octopus287/-STM32H7-/images/car_photos/car5.jpg

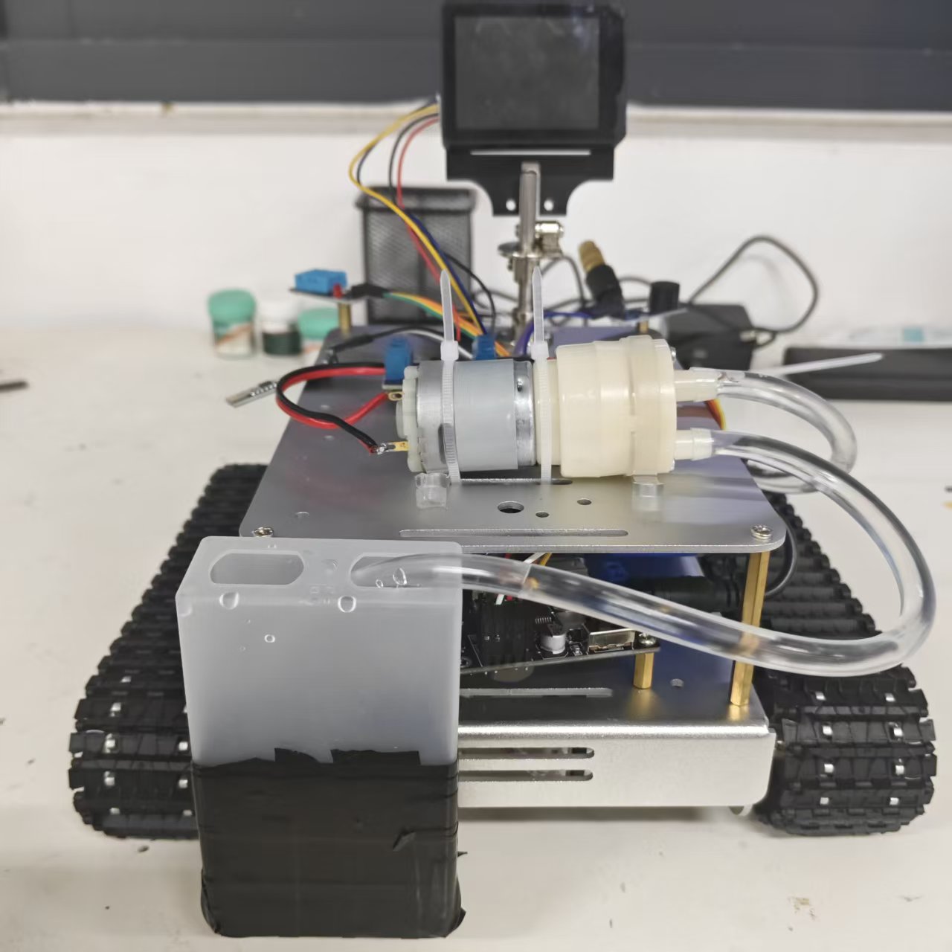
images/car_photos/car5.jpg
