octopus287/-STM32H7-/images/design/fig1-3_design_flow.png

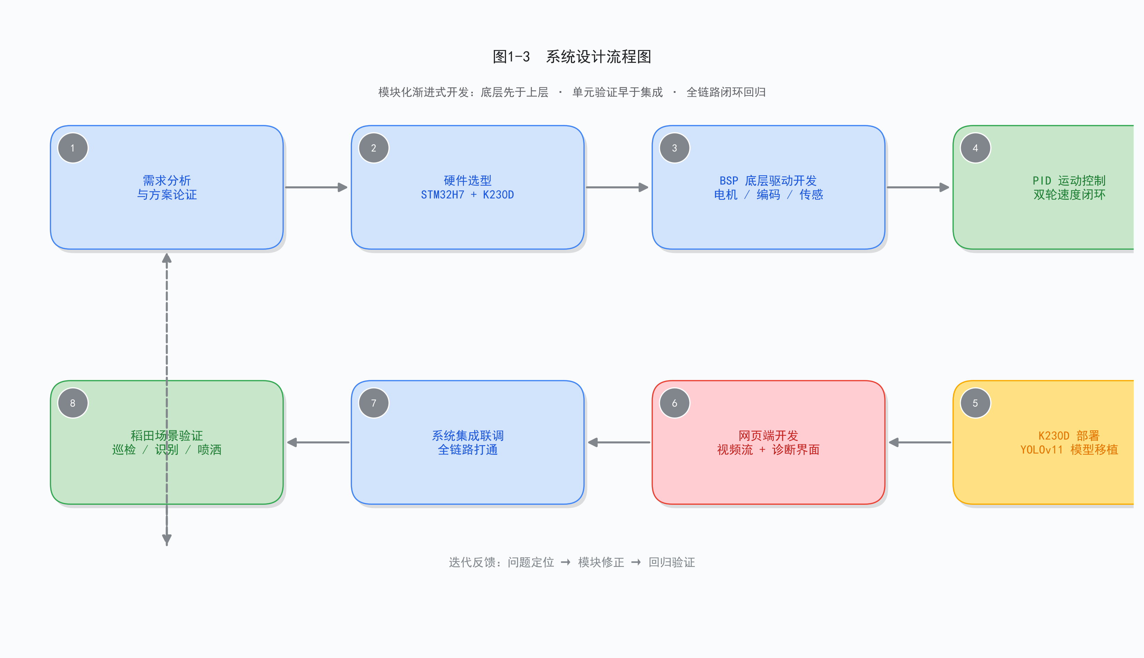
images/design/fig1-3_design_flow.png
