octopus287/-STM32H7-/images/design/fig_bt_state.png

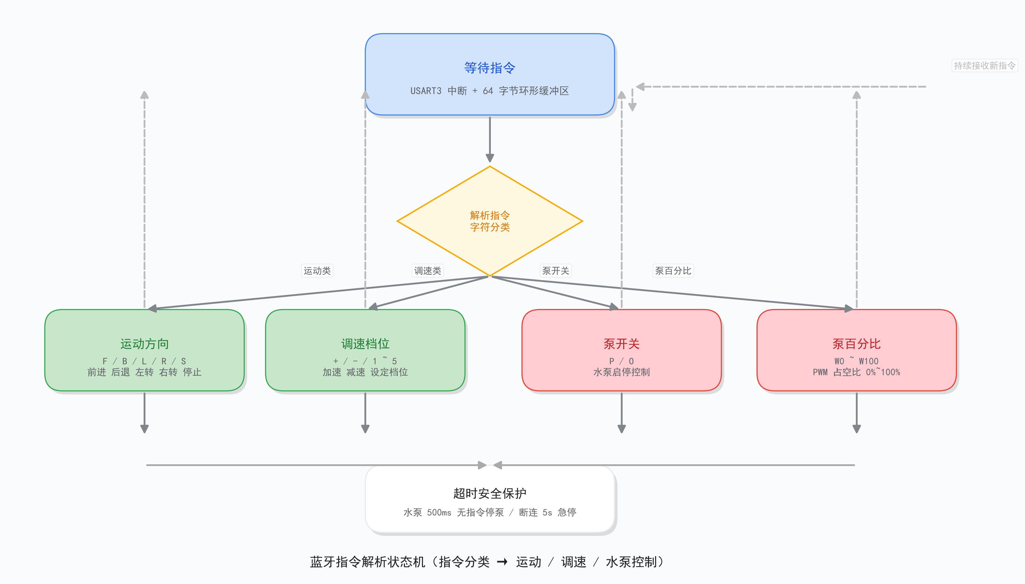
images/design/fig_bt_state.png
