octopus287/-STM32H7-/images/design/fig_pid_loop.png

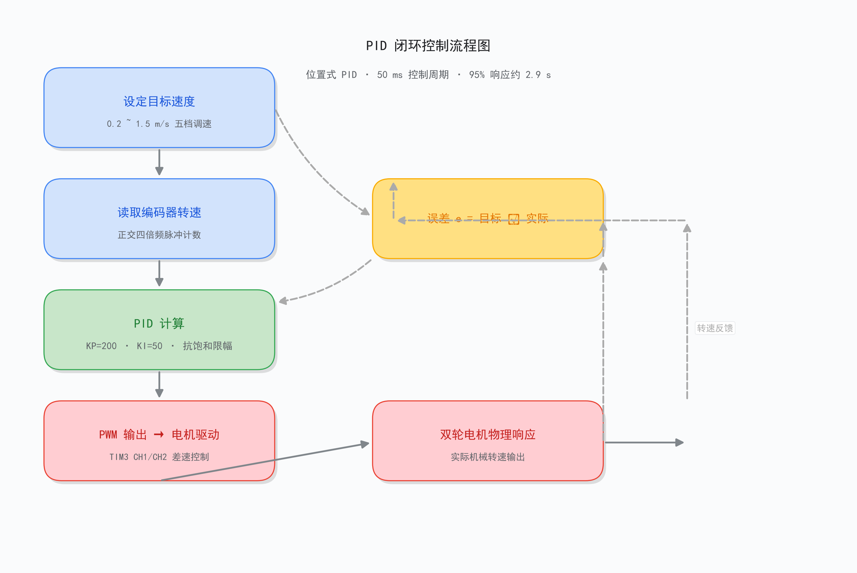
images/design/fig_pid_loop.png
