octopus287/-STM32H7-/images/field_photos/bt_disconnected.jpg

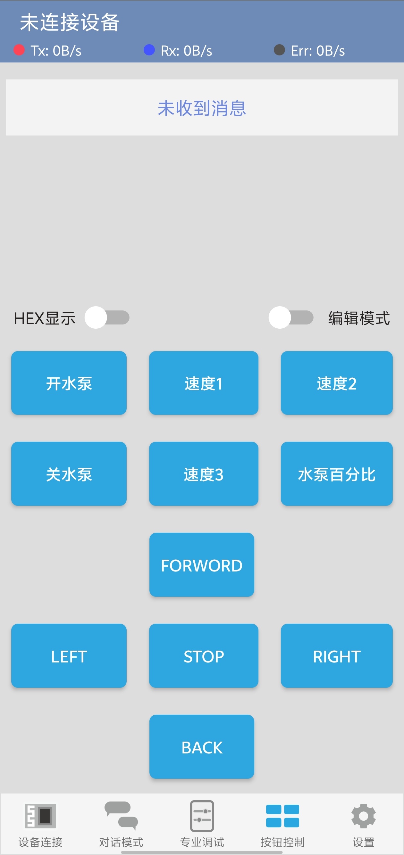
images/field_photos/bt_disconnected.jpg
