octopus287/-STM32H7-/images/field_photos/field_side_view.jpg

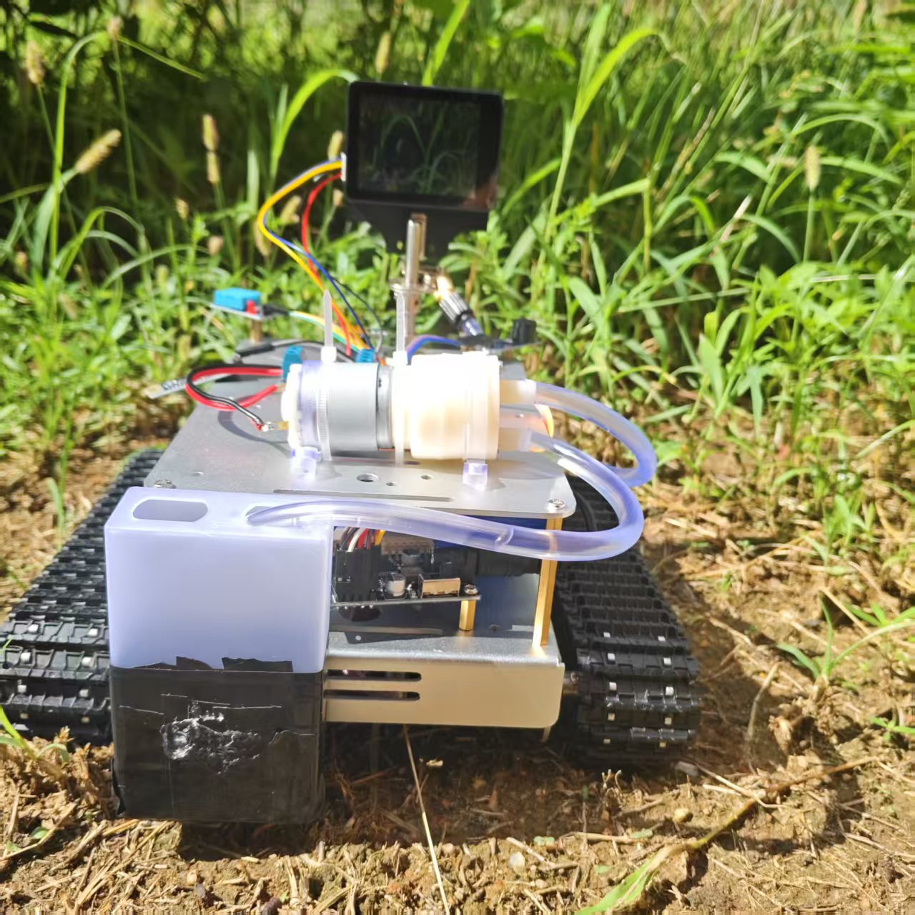
images/field_photos/field_side_view.jpg
