octopus287/-STM32H7-/firmware/Motor_Test.ioc

Mcu.UserName=STM32H743ZITx
PA0.Signal=S_TIM2_CH1_ETR
PA1.Signal=S_TIM2_CH2
PA4.Signal=GPIO_Output
PA5.Signal=GPIO_Output
PA6.Signal=GPIO_Output
PA7.Signal=GPIO_Output
PB0.Signal=S_TIM3_CH3
PB1.Signal=S_TIM3_CH4
PB10.Signal=USART3_TX
PB11.Signal=USART3_RX
PB14.Signal=USART1_TX
PB15.Signal=USART1_RX
PB6.Signal=S_TIM4_CH1
PB7.Signal=S_TIM4_CH2
PB8.Signal=I2C1_SCL
PB9.Signal=I2C1_SDA
PC0.Signal=GPIO_Output
PC1.Signal=GPIO_Input
PC8.Signal=S_TIM8_CH3
PD4.Signal=GPIO_Input
PD5.Signal=GPIO_Output
