octopus287/-STM32H7-/(commit log)

2026-10-13 初始提交：基于 STM32H7 的水稻病虫害识别与精准施药系统
    firmware: STM32H743ZITx 主控固件（Keil MDK 工程，BSP+APP 分层，双履带 PID 闭环、蓝牙遥控、OLED/DHT11/超声波、PWM 变量喷洒）
    vision: K230 CanMV 实时病虫害识别脚本（LAB 颜色阈值 + 面积比例分类）
    docs/images: 系统设计报告与实物/架构图
2026-10-13 更换项目横幅图（移除水印版本）
