octopus287/-STM32H7-/(notices)

Notices in the files:
firmware/Core/Src/gpio.c:
Copyright (c) 2026 STMicroelectronics.
All rights reserved.
This software is licensed under terms that can be found in the LICENSE file
